Hackerfarm/techrice/devices/saboten/schematics/PIN-Mapping.pdf

Sheet1

0 | PD0 | RXD0
1 | PD1 | TXD0
2 | PD2 | RXD1, INT0
3 | PD3 | TXD1, INT1
4 | PB0
5 | PB1
6 | PB2 | RTC INTERRUPT, INT2
7 | PB3
8 | PD6
9 | PD5
10 | PB4
11 | PB5
12 | PB6
13 | PB7
14 | PC6 | HIGH GAIN MODE PIN
15 | PC7
16 | PC5
17 | PC4
18 | PD4
19 | PD7
20 | PC1 | I2C SDA
21 | PC0 | I2C SCL
22 | PC2 | RADIO SLPTR PIN
23 | PC3 | RADIO CHIP SELECT
24 | PA0
25 | PA1
26 | PA2
27 | PA3
28 | PA4 | RTC CHIP SELECT
29 | PA5 | VSOLAR
30 | PA6 | RADIO INTERRUPT
31 | PA7 | VBAT
