Hackerfarm/techrice/(threads)

Thread 1 (2016-01-22):

Fix problem with envvar (currently hard-coded in app/__init__.py)

halfdanrump, 2016-01-22:

Closed 2016-01-24.

Thread 12 (2016-02-24):

Make get_time route in API

halfdanrump, 2016-02-24:
This is so the edge node can request the current time and forward it to the sensor nodes

halfdanrump, 2016-03-01:
Edge node will use NTP instead.

Closed 2016-03-01.

Thread 14 (2016-02-24):

request_time handler in edge node.

halfdanrump, 2016-02-24:
The edge node gets a request for the current time from the sensor node. The edge then sends a HTTP to the get_time URL in the API, waits for the reply, then forwards the timestamp to the correct node. The edge functions as a broker, and should have a queue or list in which it puts the short address of the sensor node that made the request. If several nodes sends a time request at the same time, then the edge only makes one HTTP request to the API, and then forwards the same time stamp to all the waiting sensor nodes.

Closed 2016-04-18.

Thread 16 (2016-03-01):

Convert NTP timestamp to year-month-day values on edge node

halfdanrump, 2016-03-01:

halfdanrump, 2016-03-03:
http://stackoverflow.com/questions/15627307/epoch-seconds-to-date-conversion-on-a-limited-embedded-device

halfdanrump, 2016-03-03:
http://www.pjrc.com/teensy/td_libs_Time.html

halfdanrump, 2016-03-03:
https://github.com/PaulStoffregen/Time/blob/master/examples/TimeNTP/TimeNTP.ino

Closed 2016-04-18.

Thread 23 (2016-03-17):

Request: DELETE several readings at once

yquemener, 2016-03-17:
It would be nice, especially for development, to be able to wipe out entire ranges of readings on a given sensor/node

halfdanrump, 2016-03-19:
Would you like to be able to delete all readings associated with a particular sensor, or specify a list of reading_id's? @yquemener

yquemener, 2016-03-21:
The problem I had was to wipe out totally test data from a given sensor. Ideally it would be doable through a range of dates, but if not possible then a specifying a (long) list of ids is probably a good idea.

Thread 25 (2016-03-19):

Disconnect the sonar power supply while in sleep mode

yquemener, 2016-03-19:
That can probably be done using a transistor triggered by a GPIO on the VCC or GND of the sonar. Halfdan suspects that disconnection only VCC or GND may allow the GPIO to still leak some current through the sonar. Let's investigate that.

yquemener, 2016-04-04:
So, disconnecting only GND leaked ~2mA through the GPIO. However, as Akiba suggested, this leak stops when the sonar trigger pin is configured as an input.

Akiba gave me this chip:
https://www.fairchildsemi.co.jp/datasheets/FD/FDC6305N.pdf that I used to disconnect the GND of the sonar and drive it through a GPIO (sonarAwakePin currently on pin 10)

Closed 2016-04-04.

Thread 27 (2016-03-19):

Outdoor testing

yquemener, 2016-03-19:
During several days, preferably including some rain episodes

yquemener, 2016-04-04:
The node #6 is now "deployed" oustide my house on top of a bucket of water, with the sonar sleep mechanism activated and a packet sent every 30 minutes.
http://api.techrice.jp/chart/node/6

Thread 30 (2016-04-06):

fix broken link when clicking on pin in map

halfdanrump, 2016-04-06:

Closed 2016-04-18.

Thread 34 (2016-06-07):

Radio Tx randomly fails on Saboten when USB is connected (ground issue?)

yquemener, 2016-06-07:
When USB is connected to a saboten board, the radio link does not transmit (tried through the new range_test sketches), whether the power switch is on BATT or USB.

However, when I touch the ground plane, transmission occurs (at half the signal strength).

If I switch to battery mode and disconnect the USB, it works fine.
