Hackerfarm/techrice/devices/saboten/schematics/Schematic-Saboten-900-MHz-Long-Range-v1.1.pdf

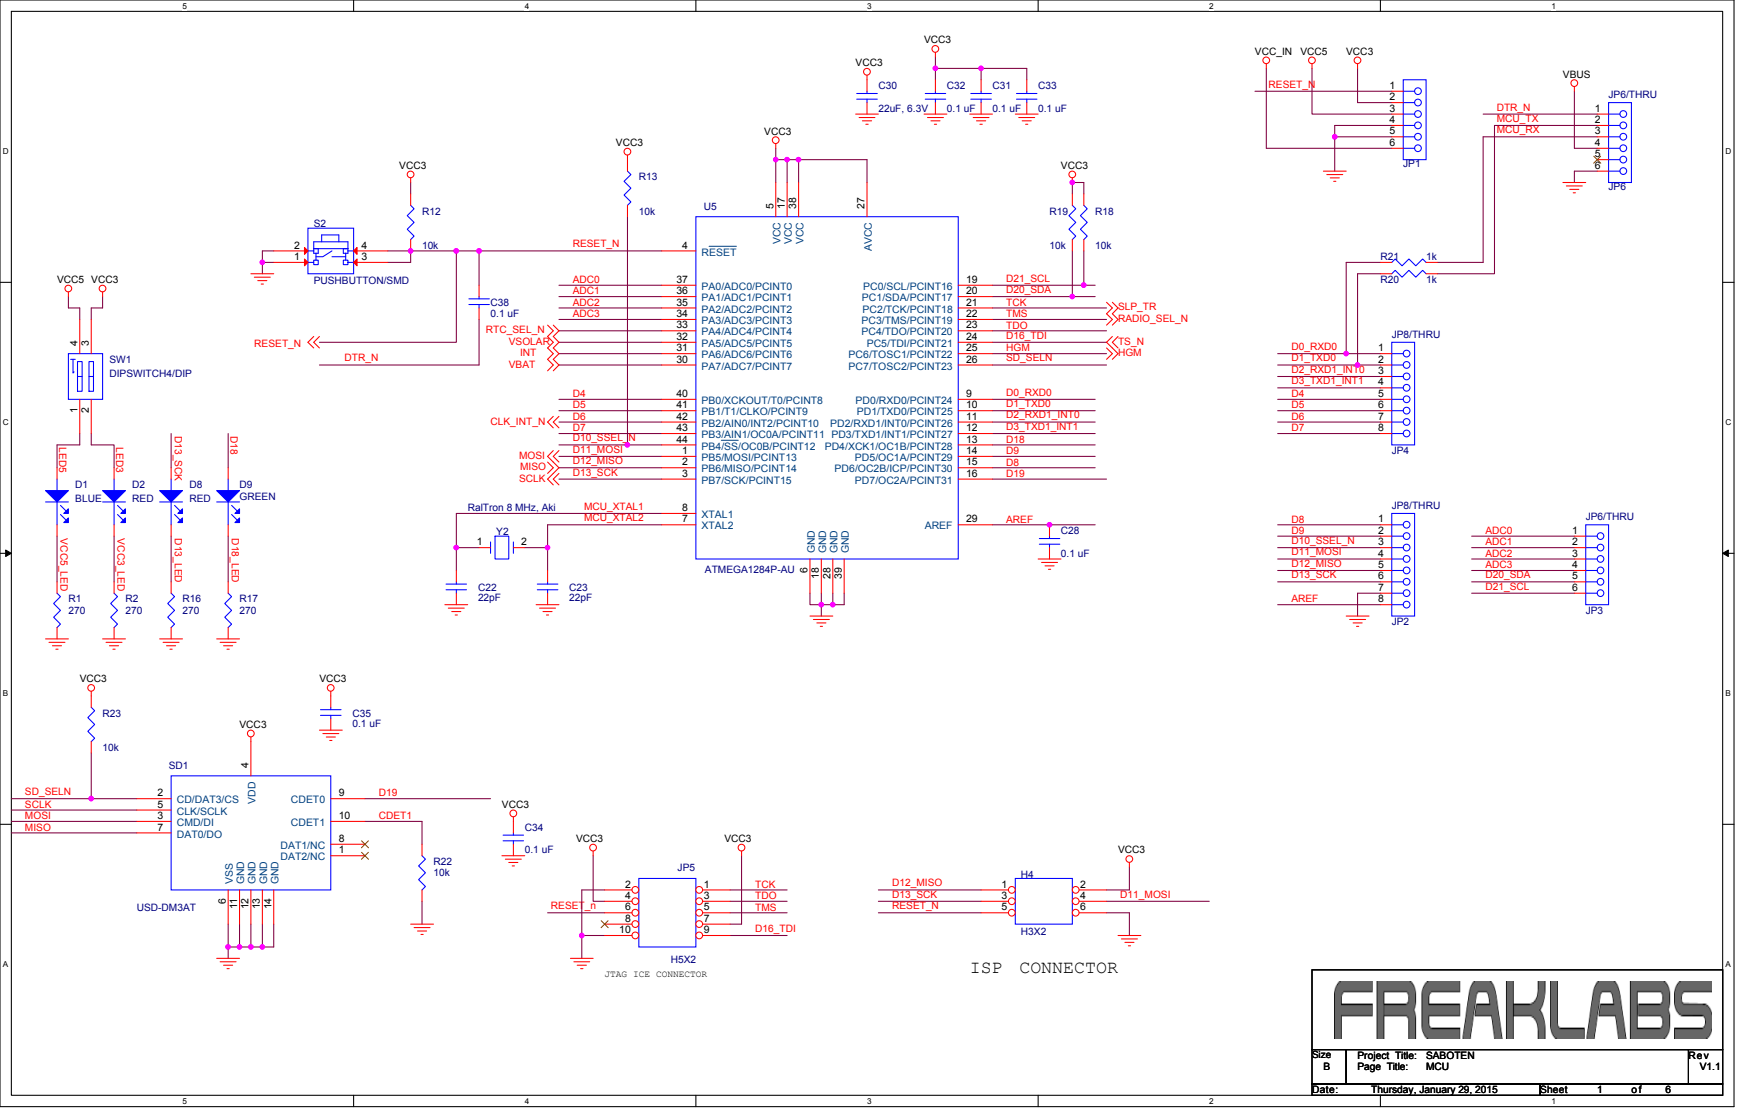
[picture p1: page 1]

Size Size Size B B B | Project Title: Project Title: Project Title: SABOTEN SABOTEN SABOTEN Page Title: Page Title: Page Title: MCU MCU MCU | Rev Rev Rev V1.1 V1.1 V1.1

Date: Date: Date: Thursday, January 29, 2015 Thursday, January 29, 2015 Thursday, January 29, 2015 | Sheet Sheet Sheet 1 1 1 of of of 6 6 6

D | D

H3

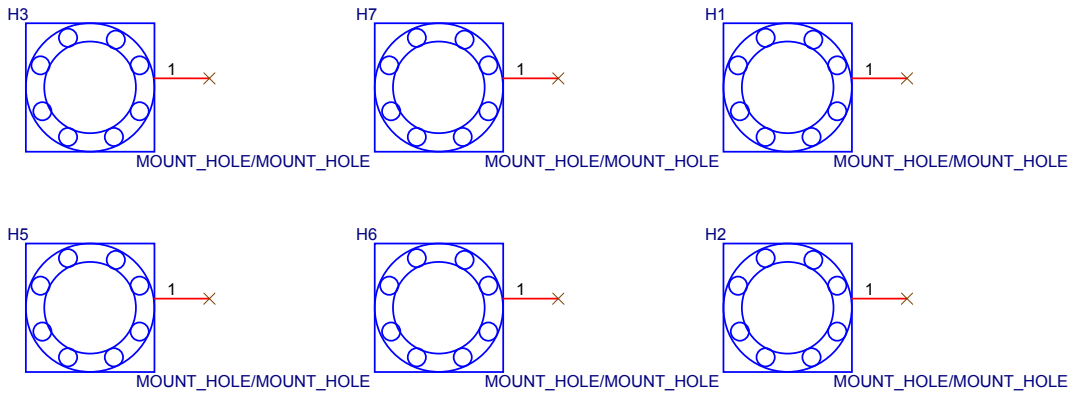
[picture p2: page 2]
MOUNT_HOLE/MOUNT_HOLE

Size Size Size A A A | Project Title: Project Title: Project Title: SABOTEN SABOTEN SABOTEN Page Title: Page Title: Page Title: MISC MISC MISC | Rev Rev Rev V1.1 V1.1 V1.1

Date: Date: Date: Thursday, January 29, 2015 Thursday, January 29, 2015 Thursday, January 29, 2015 | Sheet Sheet Sheet 2 2 2 of of of 6 6 6

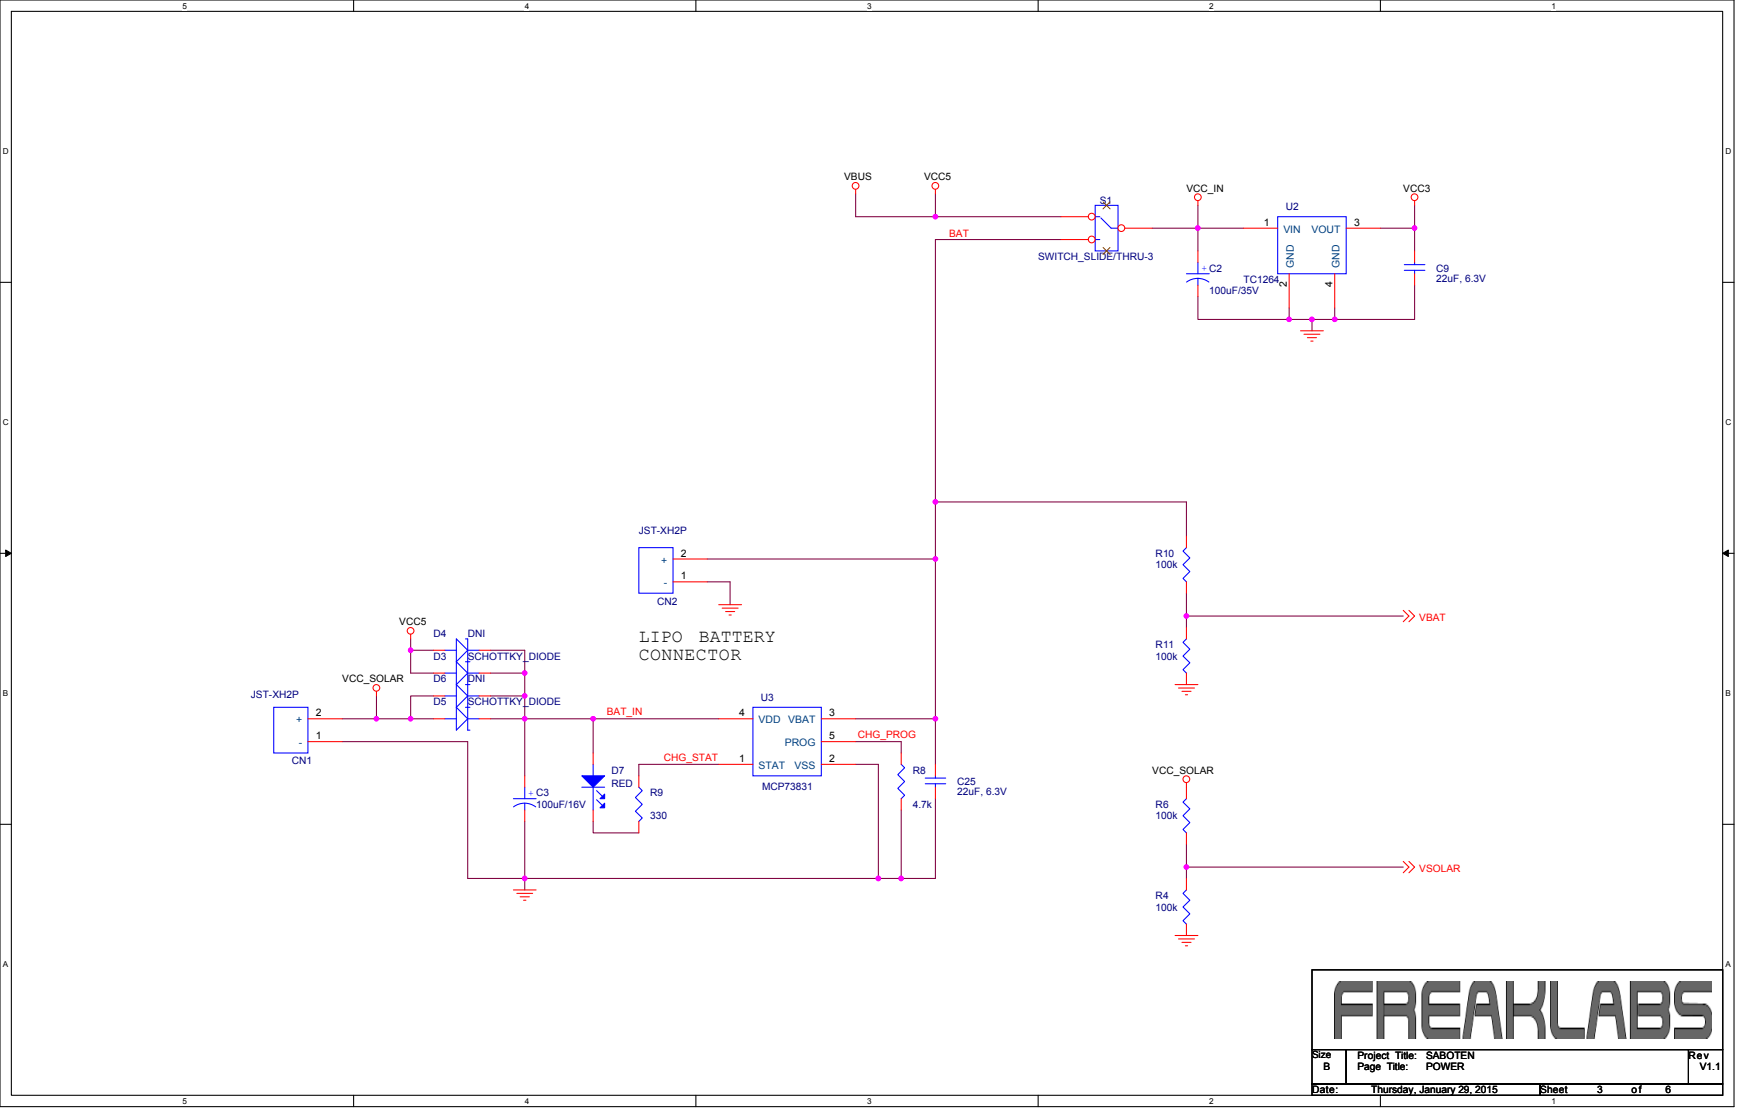
[picture p3: page 3]

Size Size Size B B B | Project Title: Project Title: Project Title: SABOTEN SABOTEN SABOTEN Page Title: Page Title: Page Title: POWER POWER POWER | Rev Rev Rev V1.1 V1.1 V1.1

Date: Date: Date: Thursday, January 29, 2015 Thursday, January 29, 2015 Thursday, January 29, 2015 | Sheet Sheet Sheet 3 3 3 of of of 6 6 6

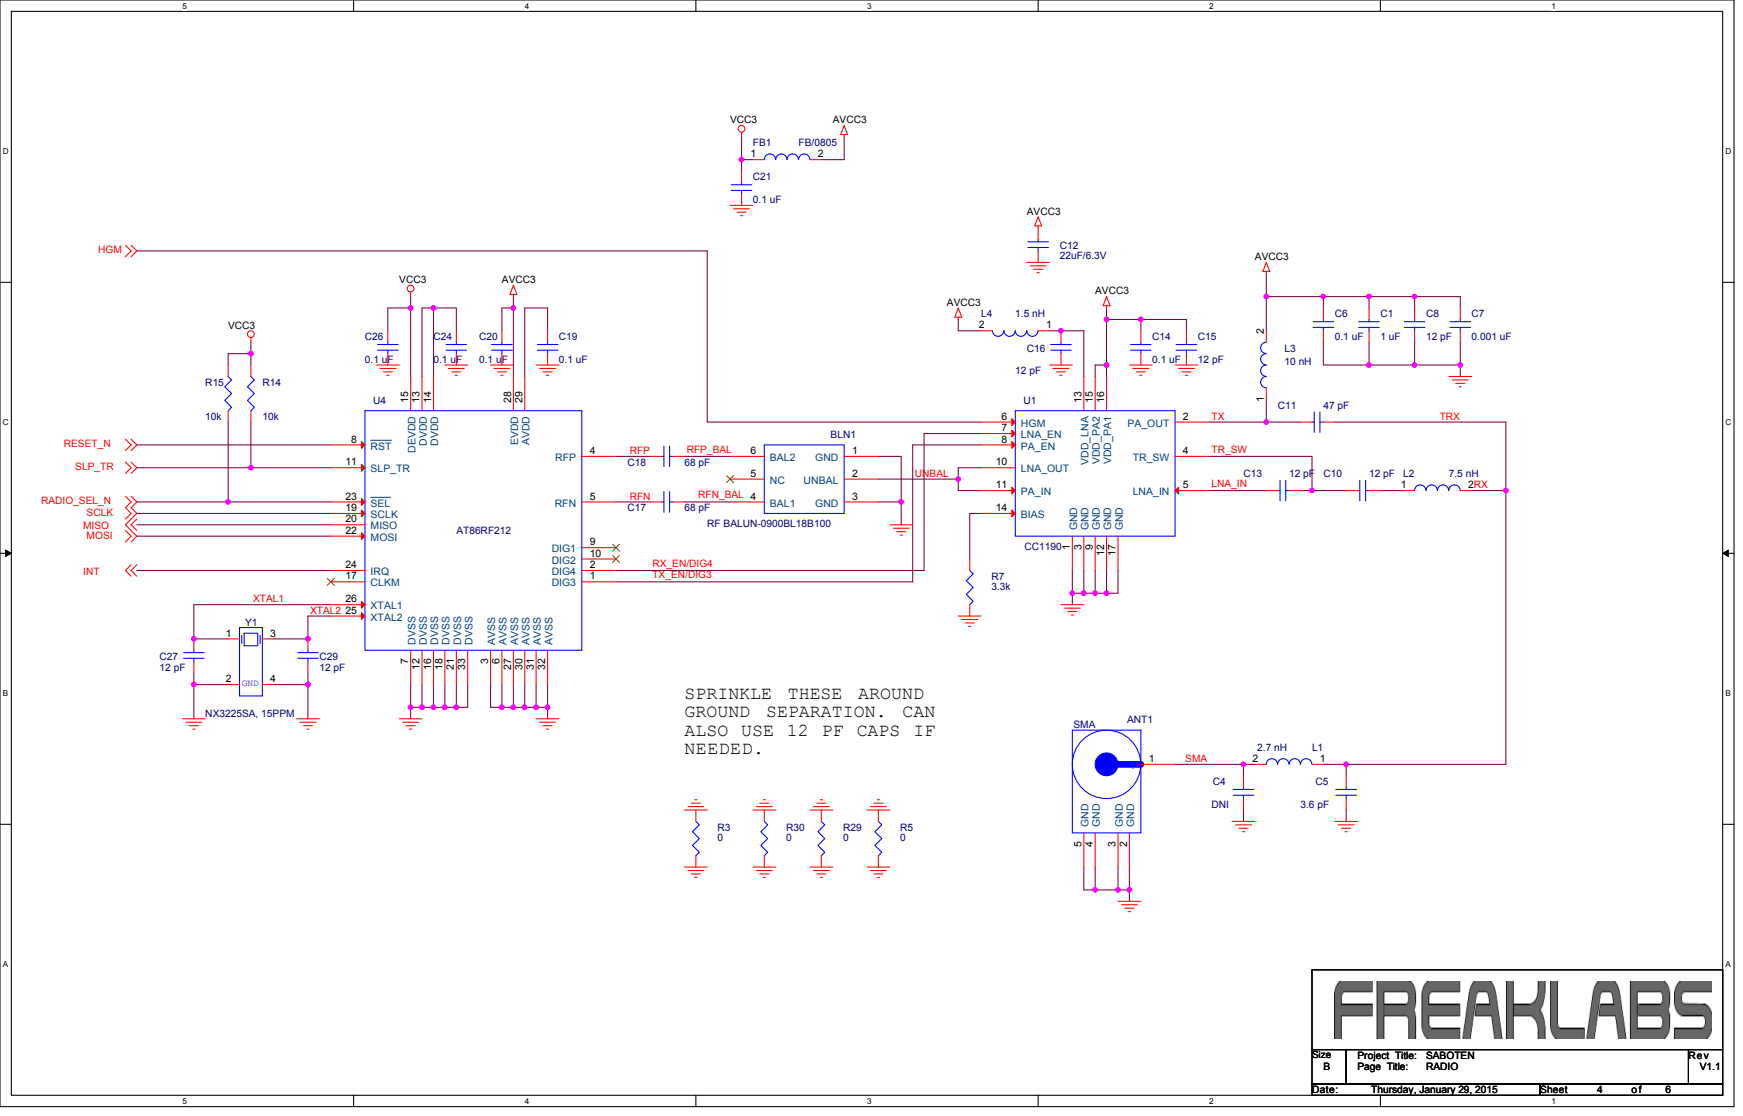
[picture p4: page 4]

SPRINKLE THESE AROUND
GROUND SEPARATION. CAN
ALSO USE 12 PF CAPS IF
NEEDED.

Size Size Size B B B | Project Title: Project Title: Project Title: SABOTEN SABOTEN SABOTEN Page Title: Page Title: Page Title: RADIO RADIO RADIO | Rev Rev Rev V1.1 V1.1 V1.1

Date: Date: Date: Thursday, January 29, 2015 Thursday, January 29, 2015 Thursday, January 29, 2015 | Sheet Sheet Sheet 4 4 4 of of of 6 6 6

D | D
VCC3 | VCC3

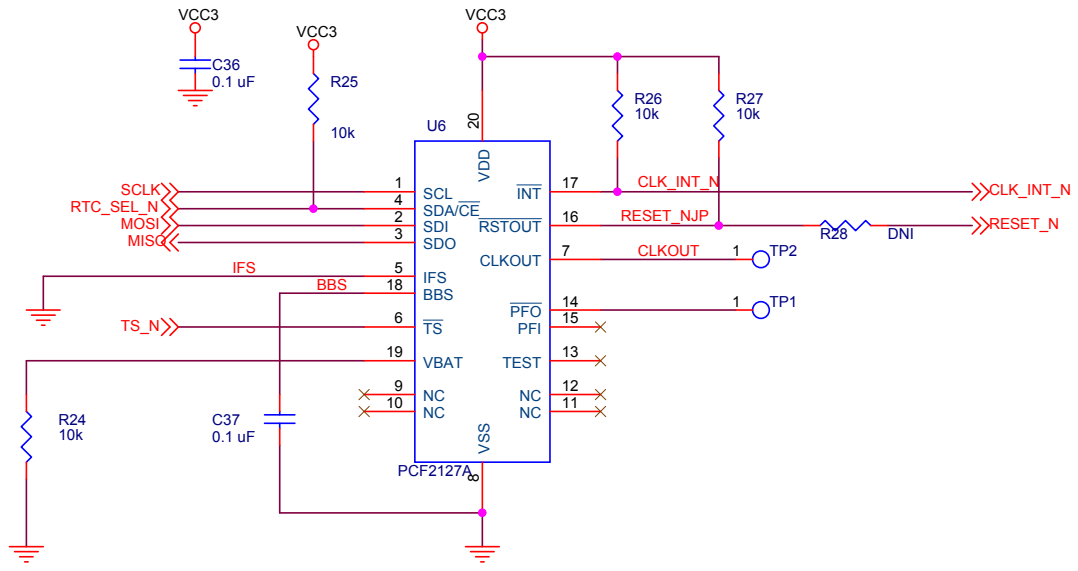
[picture p5: page 5]

Size Size Size A A A | Project Title: Project Title: Project Title: SABOTEN SABOTEN SABOTEN Page Title: Page Title: Page Title: RTC RTC RTC | Rev Rev Rev V1.1 V1.1 V1.1

Date: Date: Date: Thursday, January 29, 2015 Thursday, January 29, 2015 Thursday, January 29, 2015 | Sheet Sheet Sheet 5 5 5 of of of 6 6 6
