Hackerfarm/techrice/devices/arashiv2/schematics/arashi-gateway-900m-lr-v2,0.pdf

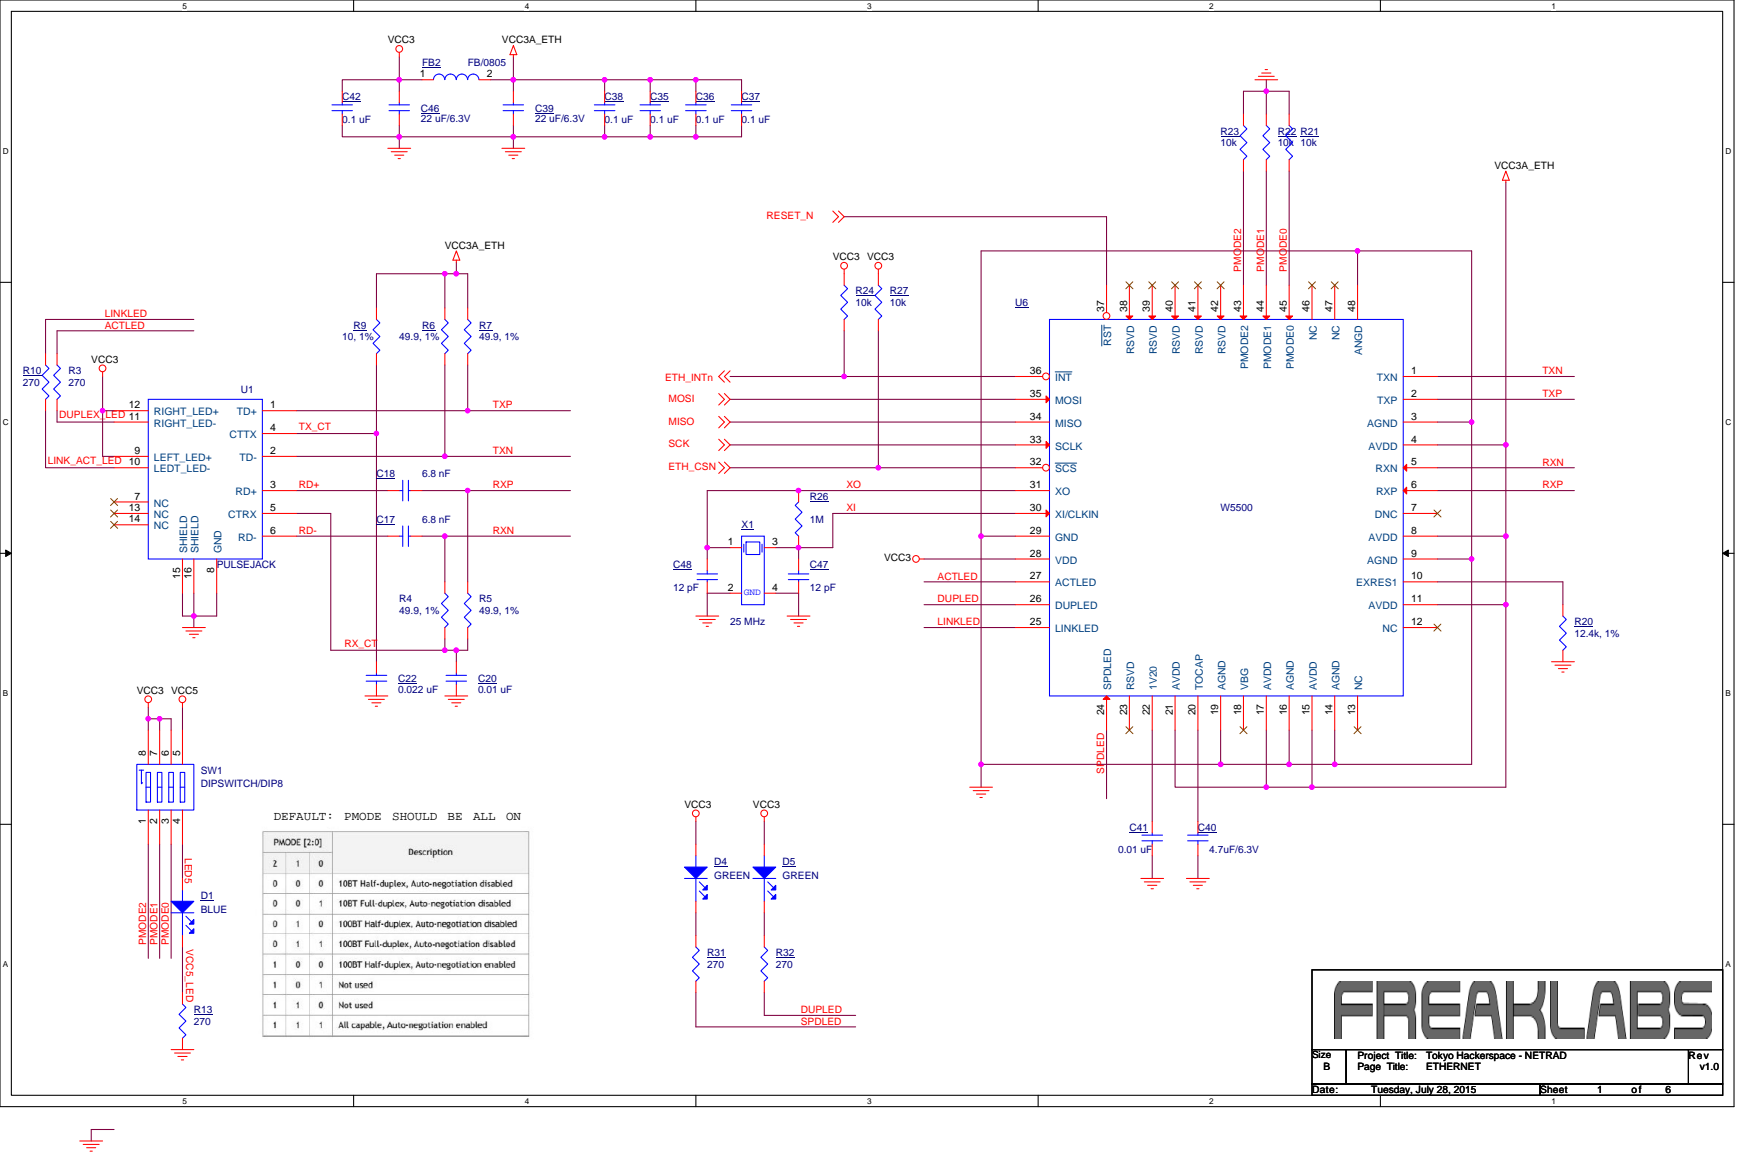
[picture p6: page 1]

DEFAULT: PMODE SHOULD BE ALL ON

Size Size Size B B B | Project Title: Project Title: Project Title: Tokyo Hackerspace - NETRAD Tokyo Hackerspace - NETRAD Tokyo Hackerspace - NETRAD Page Title: Page Title: Page Title: ETHERNET ETHERNET ETHERNET | Rev Rev Rev v1.0 v1.0 v1.0

Date: Date: Date: Tuesday, July 28, 2015 Tuesday, July 28, 2015 Tuesday, July 28, 2015 | Sheet Sheet Sheet 1 1 1 of of of 6 6 6

D | D

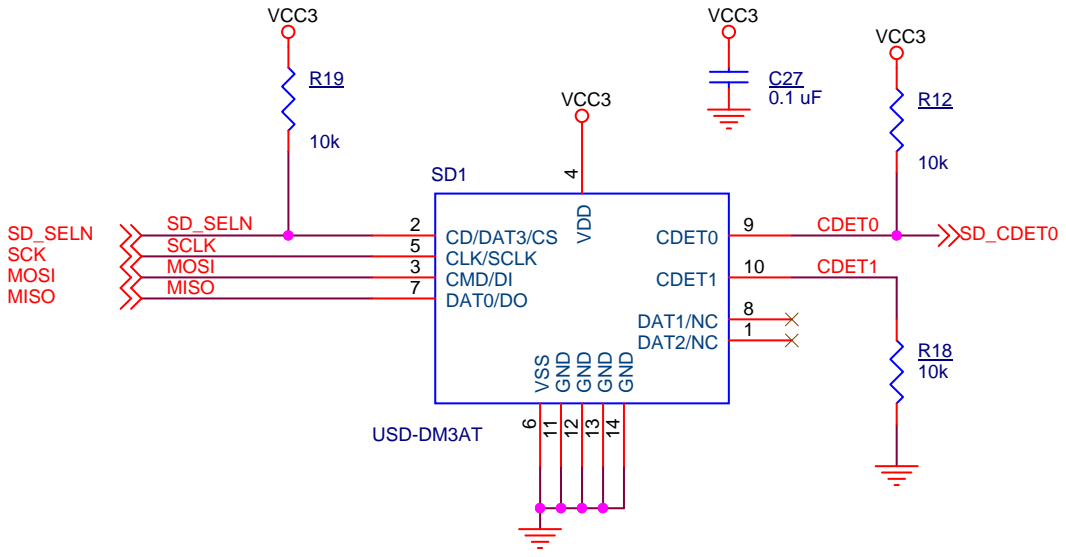
[picture p7: page 2]
SD_SELN SCLK; MISO; MOSI; CDET0; CDET1; VCC3; SD_SELN SCK MOSI MISO; SD_CDET0; Title; <Doc>; <RevCod; <Title>; USD-DM3AT; DAT2/NC; CD/DAT3/CS 2; CMD/DI 3; VDD; CLK/SCLK 5; VSS; DAT0/DO 7; DAT1/NC; GND 11; GND 12; GND 13; GND 14

Size Size Size A A A | Document Number Document Number Document Number | Rev Rev Rev

Date: Tuesday, July 28, 2015 Tuesday, July 28, 2015 Tuesday, July 28, 2015 | Sheet 1 1 1 of 1 1 1

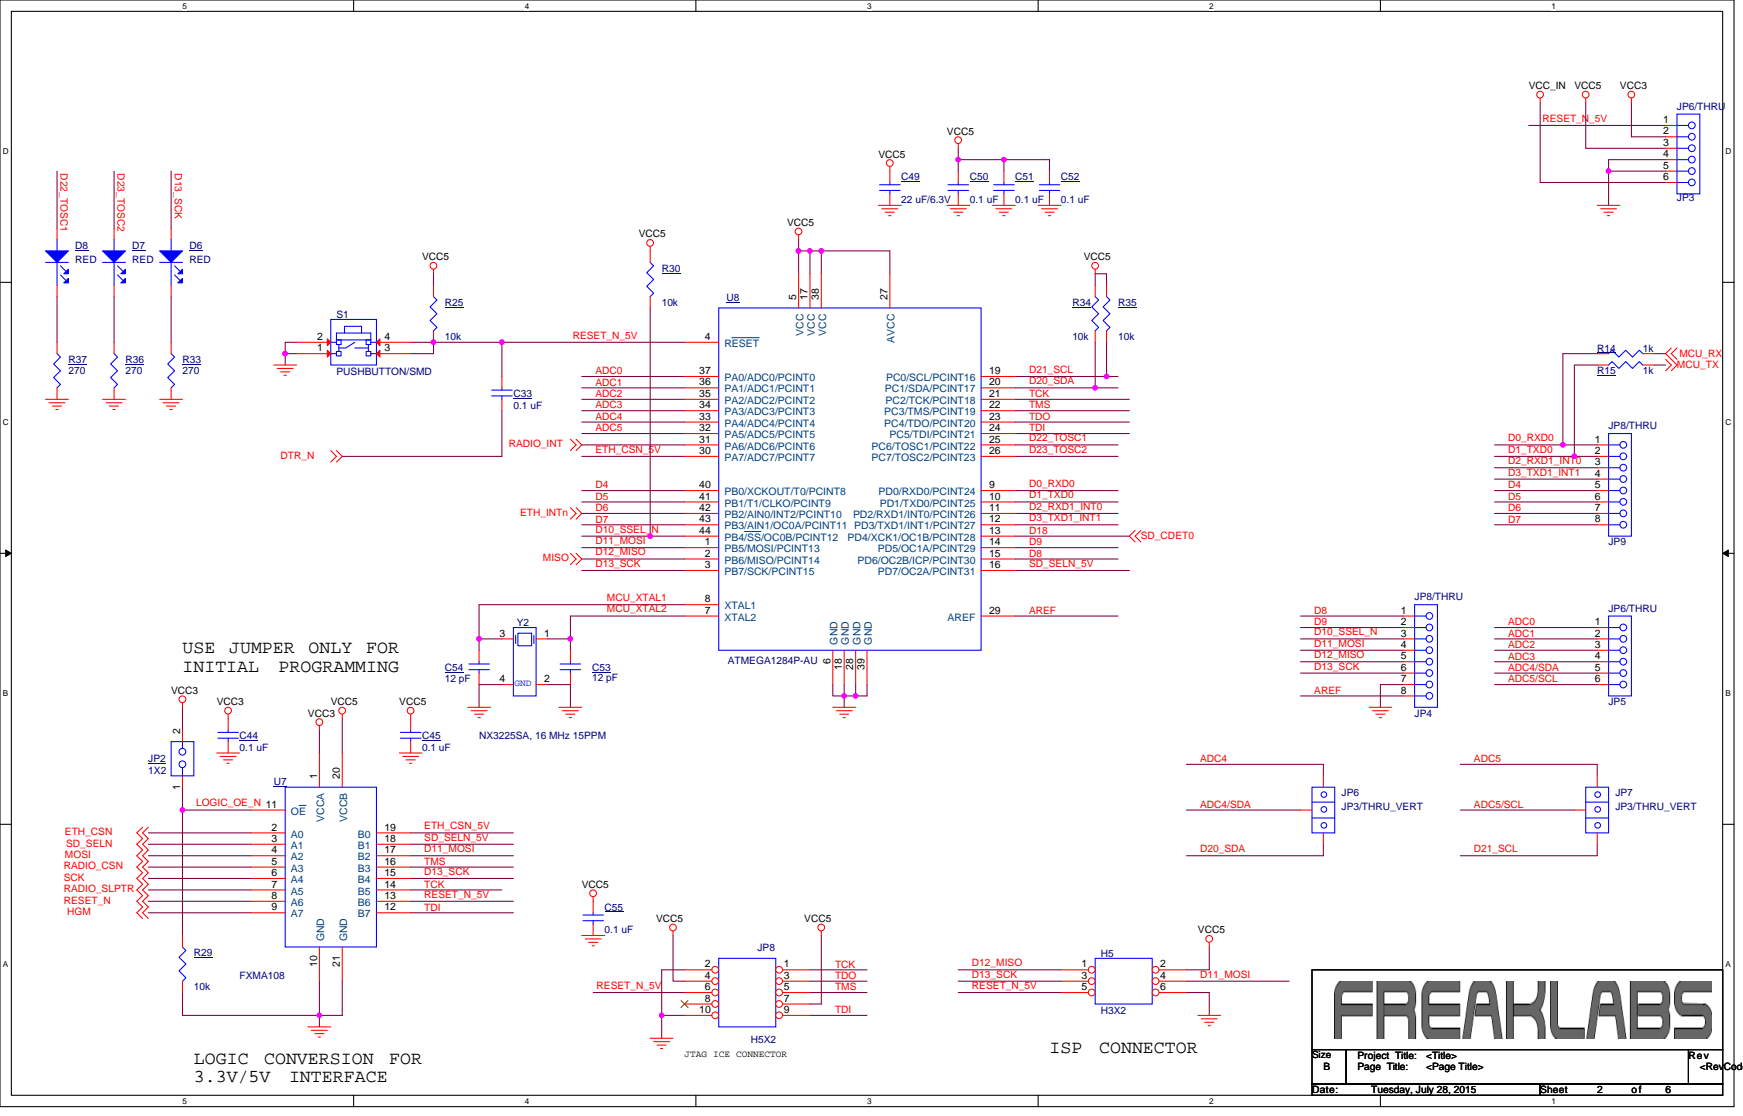
[picture p8: page 3]

USE JUMPER ONLY FOR
INITIAL PROGRAMMING

Size Size Size B B B | Project Title: Project Title: Project Title: <Title> <Title> <Title> <Page Title> <Page Title> <Page Title> | Rev Rev Rev

Date: Date: Date: Tuesday, July 28, 2015 Tuesday, July 28, 2015 Tuesday, July 28, 2015 | Sheet Sheet Sheet 2 2 2 of of of 6 6 6

D | D

H4

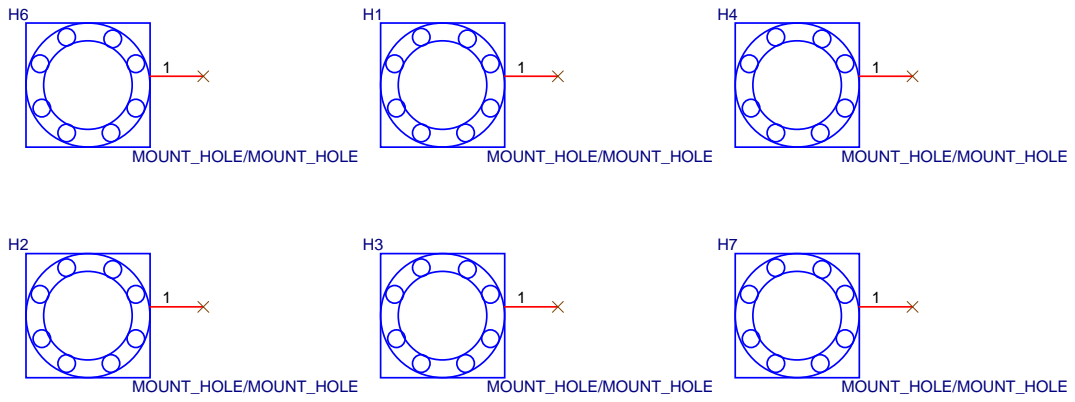
[picture p9: page 4]
Page Title:; <RevCod; MOUNT_HOLE/MOUNT_HOLE

Size Size Size A A A | Project Title: Project Title: Project Title: <Title> <Title> <Title> <Page Title> <Page Title> <Page Title> | Rev Rev Rev

Thursday, July 23, 2015 Thursday, July 23, 2015 Thursday, July 23, 2015 | 3 3 3 6 6 6

D | D

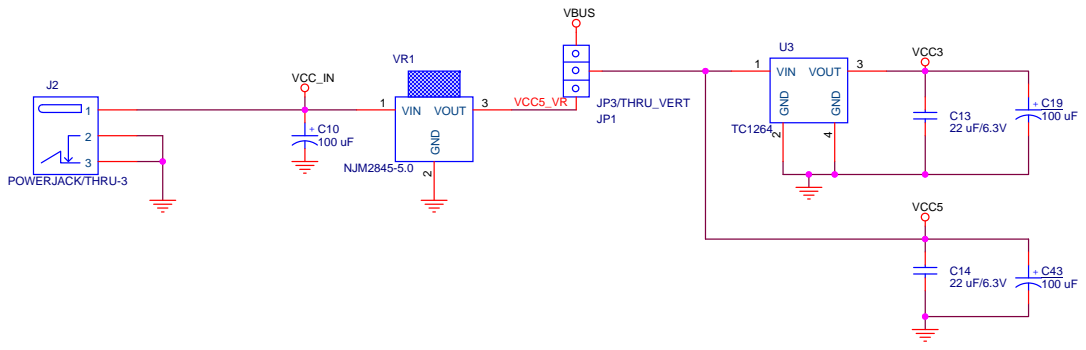
[picture p10: page 5]
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

Tuesday, July 28, 2015 Tuesday, July 28, 2015 Tuesday, July 28, 2015 | 4 4 4 6 6 6

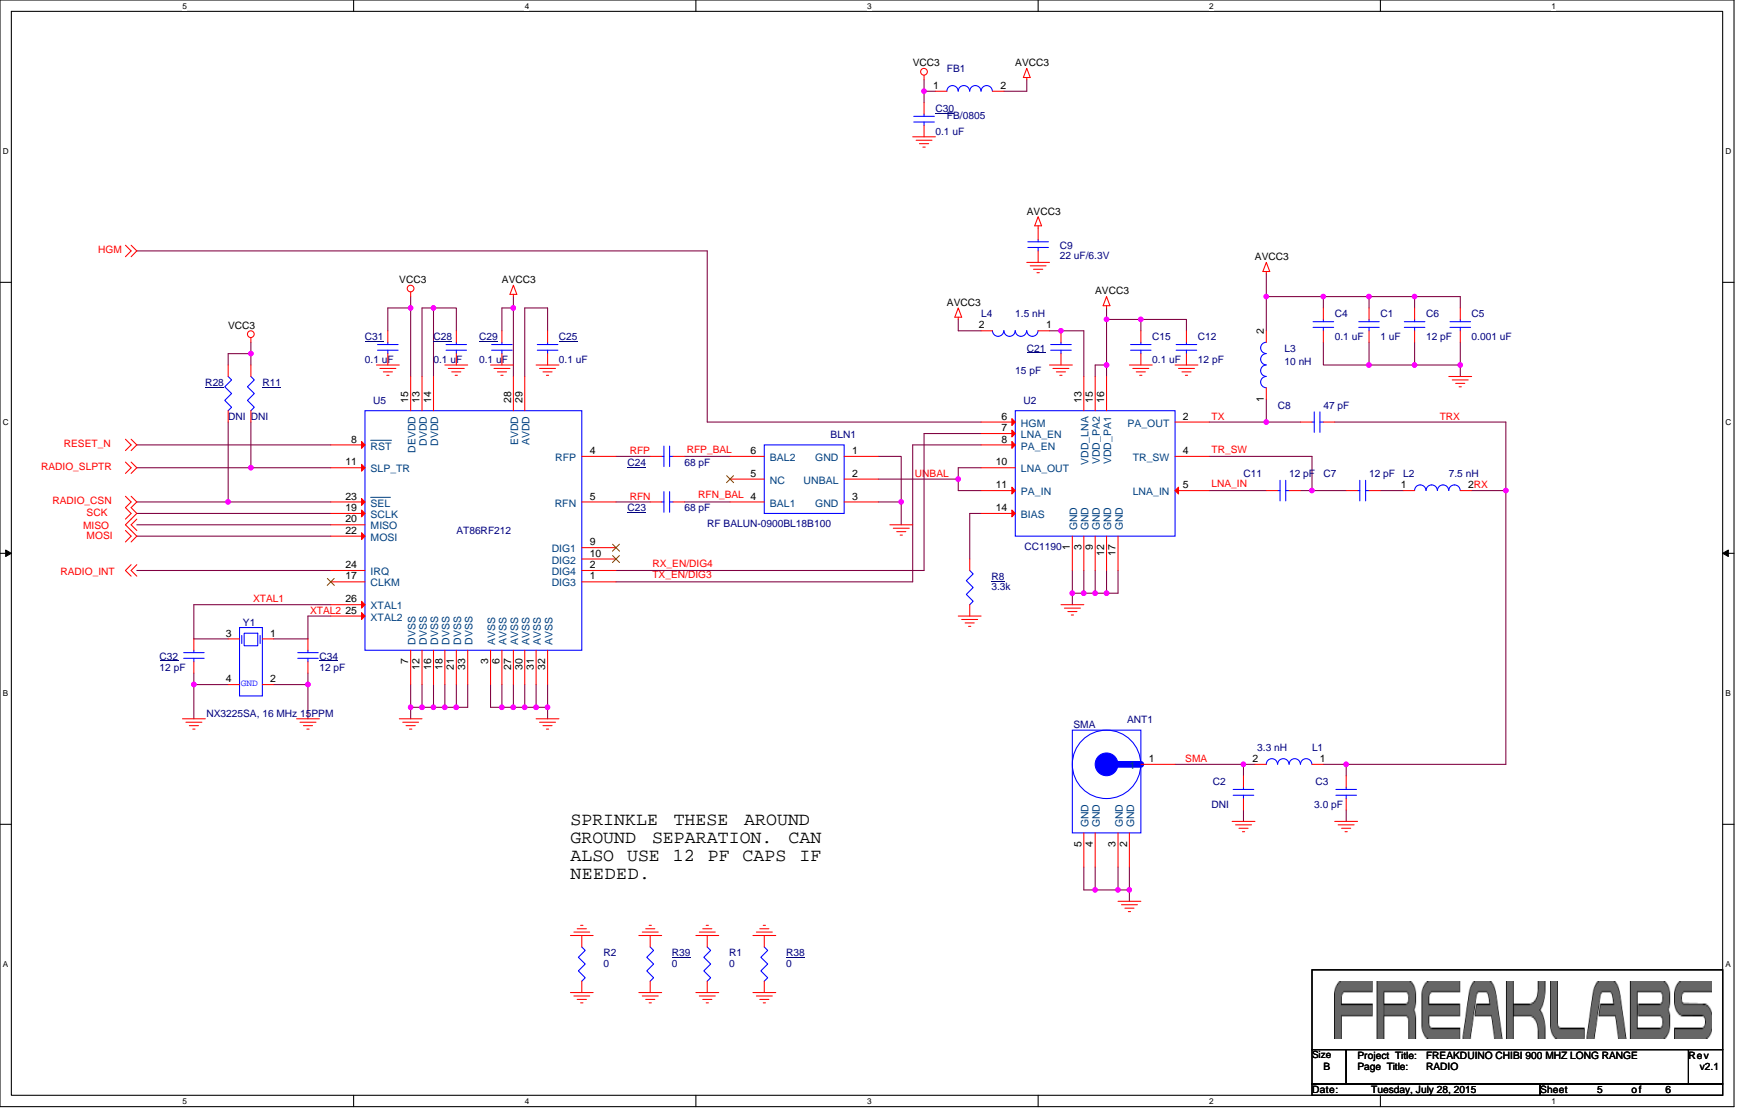
[picture p11: page 6]

SPRINKLE THESE AROUND
GROUND SEPARATION. CAN
ALSO USE 12 PF CAPS IF
NEEDED.

Size Size Size B B B | Project Title: Project Title: Project Title: FREAKDUINO CHIBI 900 MHZ LONG RANGE FREAKDUINO CHIBI 900 MHZ LONG RANGE FREAKDUINO CHIBI 900 MHZ LONG RANGE Page Title: Page Title: Page Title: RADIO RADIO RADIO | Rev Rev Rev v2.1 v2.1 v2.1

Date: Date: Date: Tuesday, July 28, 2015 Tuesday, July 28, 2015 Tuesday, July 28, 2015 | Sheet Sheet Sheet 5 5 5 of of of 6 6 6

D | D

## VBUS

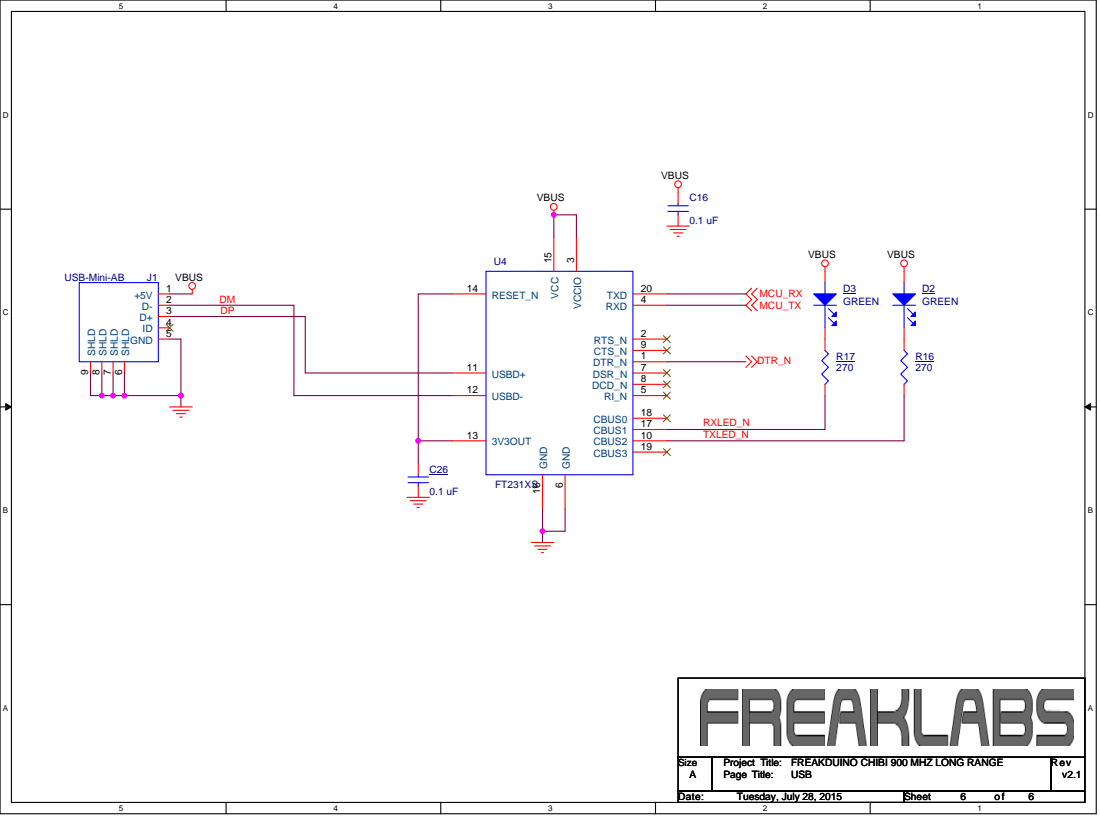
[picture p12: page 7]

VCC 15 GND 16 CBUS1 17 CBUS0 18 CBUS3 19 TXD 20 USB-Mini-AB J1 D+ 3 D- 2 +5V 1 GND 5 ID 4

Size Size Size A A A | Project Title: Project Title: Project Title: FREAKDUINO CHIBI 900 MHZ LONG RANGE FREAKDUINO CHIBI 900 MHZ LONG RANGE FREAKDUINO CHIBI 900 MHZ LONG RANGE Page Title: Page Title: Page Title: USB USB USB | Rev Rev Rev v2.1 v2.1 v2.1

Tuesday, July 28, 2015 Tuesday, July 28, 2015 Tuesday, July 28, 2015 | 6 6 6
