Hackerfarm/techrice/devices/3g/schematics/SHIELD_SIM5216_ASM (2).pdf

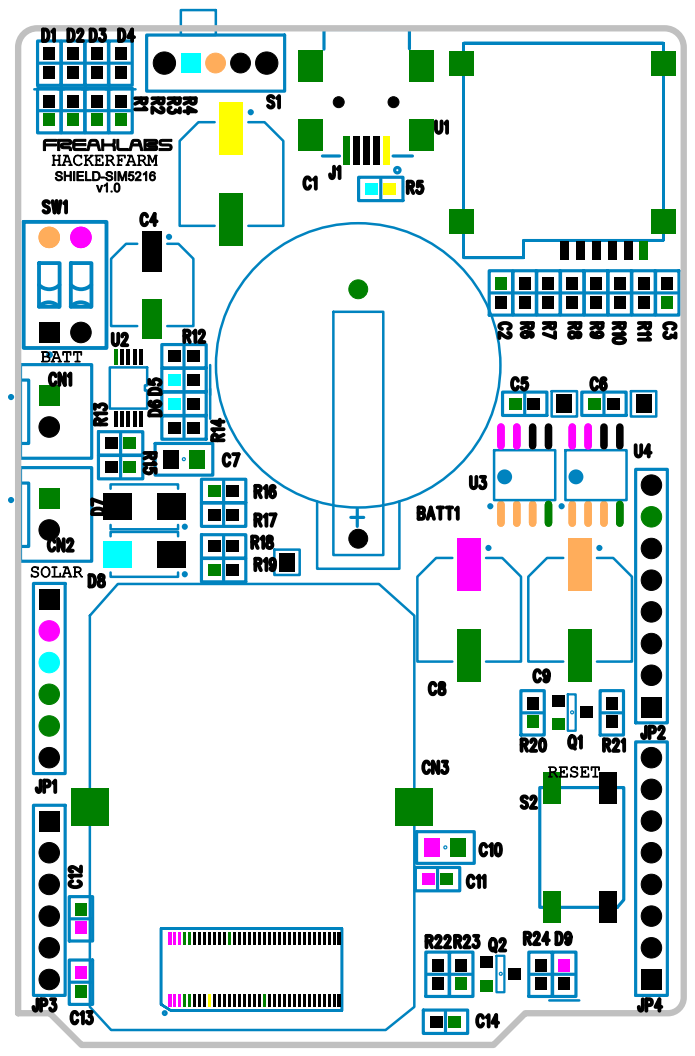
[picture p13: page 1]
