Hackerfarm/techrice/(commit log)

2015-12-14 Adds simple admin panel
    [babel.cfg]
2015-12-28 Adds PCF2127 RTC driver
2015-12-30 Added device software files for arashi v2
    Initial commit
2015-12-30 Added schematic for arashi v2
    Added schematic for arashi v2
2015-12-31 Synchronized chibiArduino with current version in repo
    Modified chibiArduino to support many new boards. Later we need to
    delete this branch and just reference the main branch of chibiArduino.
    But for now, lets just maintain a separate known working branch here.
2016-01-10 Adds SensorType resource handlers
2016-01-10 Fixes bad route for POST /sensor
2016-01-23 Adds unique constraint on sensortype name
2016-01-23 Makes handy functions for setting up new techrice sensor nodes
2016-01-28 Adds power management to saboten. Wakes up every minute and posts data.
2016-01-30 Reverts Akibas arashi sketch to the original state
    [test_arashi_v2_1284p_eth.ino]
2016-02-03 Nodes pushing temperature info to the Tornado server
2016-02-06 Removes printing server reply.
2016-02-06 Adds saboten and 3G board schematics
2016-02-06 Shortens json repr of sensor
2016-02-19 Removes admin panel
    [babel.cfg]
2016-02-19 Moves shared libraries to root library folder and creates folder hierarchy for each device
2016-02-27 Changes sonar name
2016-02-27 Adds descripion columns to Sensor and SensorType models
2016-03-06 Added sonar_test to the sketches
2016-03-06 And in a correct place
    [sonar_test.ino]
2016-03-08 Makes it possible to list nodes and sensors without specifying parents
2016-03-16 Sonar and radio tests
2016-03-16 Corrects HGM pin
2016-03-19 Adds saboten pin mapping document
2016-03-30 Capitalizes sensor id constant definitions
2016-04-04 Added the sonar wakeup features
2016-04-11 Relates to same issue as previous commit. Fixes more bugs in header response, and updates sensor names in techrice_node.ino. Sketch now complies with API generated header.
    [techrice_node.ino]
2016-04-11 Wrapping in fixed-size packets works! Data is sent correctly from saboten to arashi
    [techrice_node.ino]
2016-04-14 Working setup with chibi_node sending dummy data to chibi_edge. Chibi boards are used for testing purposes when sabotens are not avialable
2016-04-16 Fixes crosses initialization of errors by adding scope to swtich case statements
2016-04-16 techrice_edge compiles with switch-case statement
2016-07-01 Temporarily deativated sdcards Fixed the range test arashi Added pullup input for the burst mode
    [range_test_saboten.ino, techrice_node.ino]
2016-08-14 Tested for range test and power tests
2016-08-14 Now reads eeprom config at start. Accepts serial commands when started in debug mode (pin 4 at LOW)
2017-06-06 Now sends all sensors information
2017-06-06 Now supports OneWire temperature sensors
